mrmoje/RTR160_REMOTE_START/(list of files, cad)

Other CAD files:
firmware/PIC16f628A.X/dist/default/production/PIC16f628A.X.production.obj
firmware/PIC16f628A.X/l.obj
firmware/PIC16f628A.X/dist/default/production/p16f628a_test.X.production.obj
