mrmoje/RTR160_REMOTE_START/hardware/board.pdf

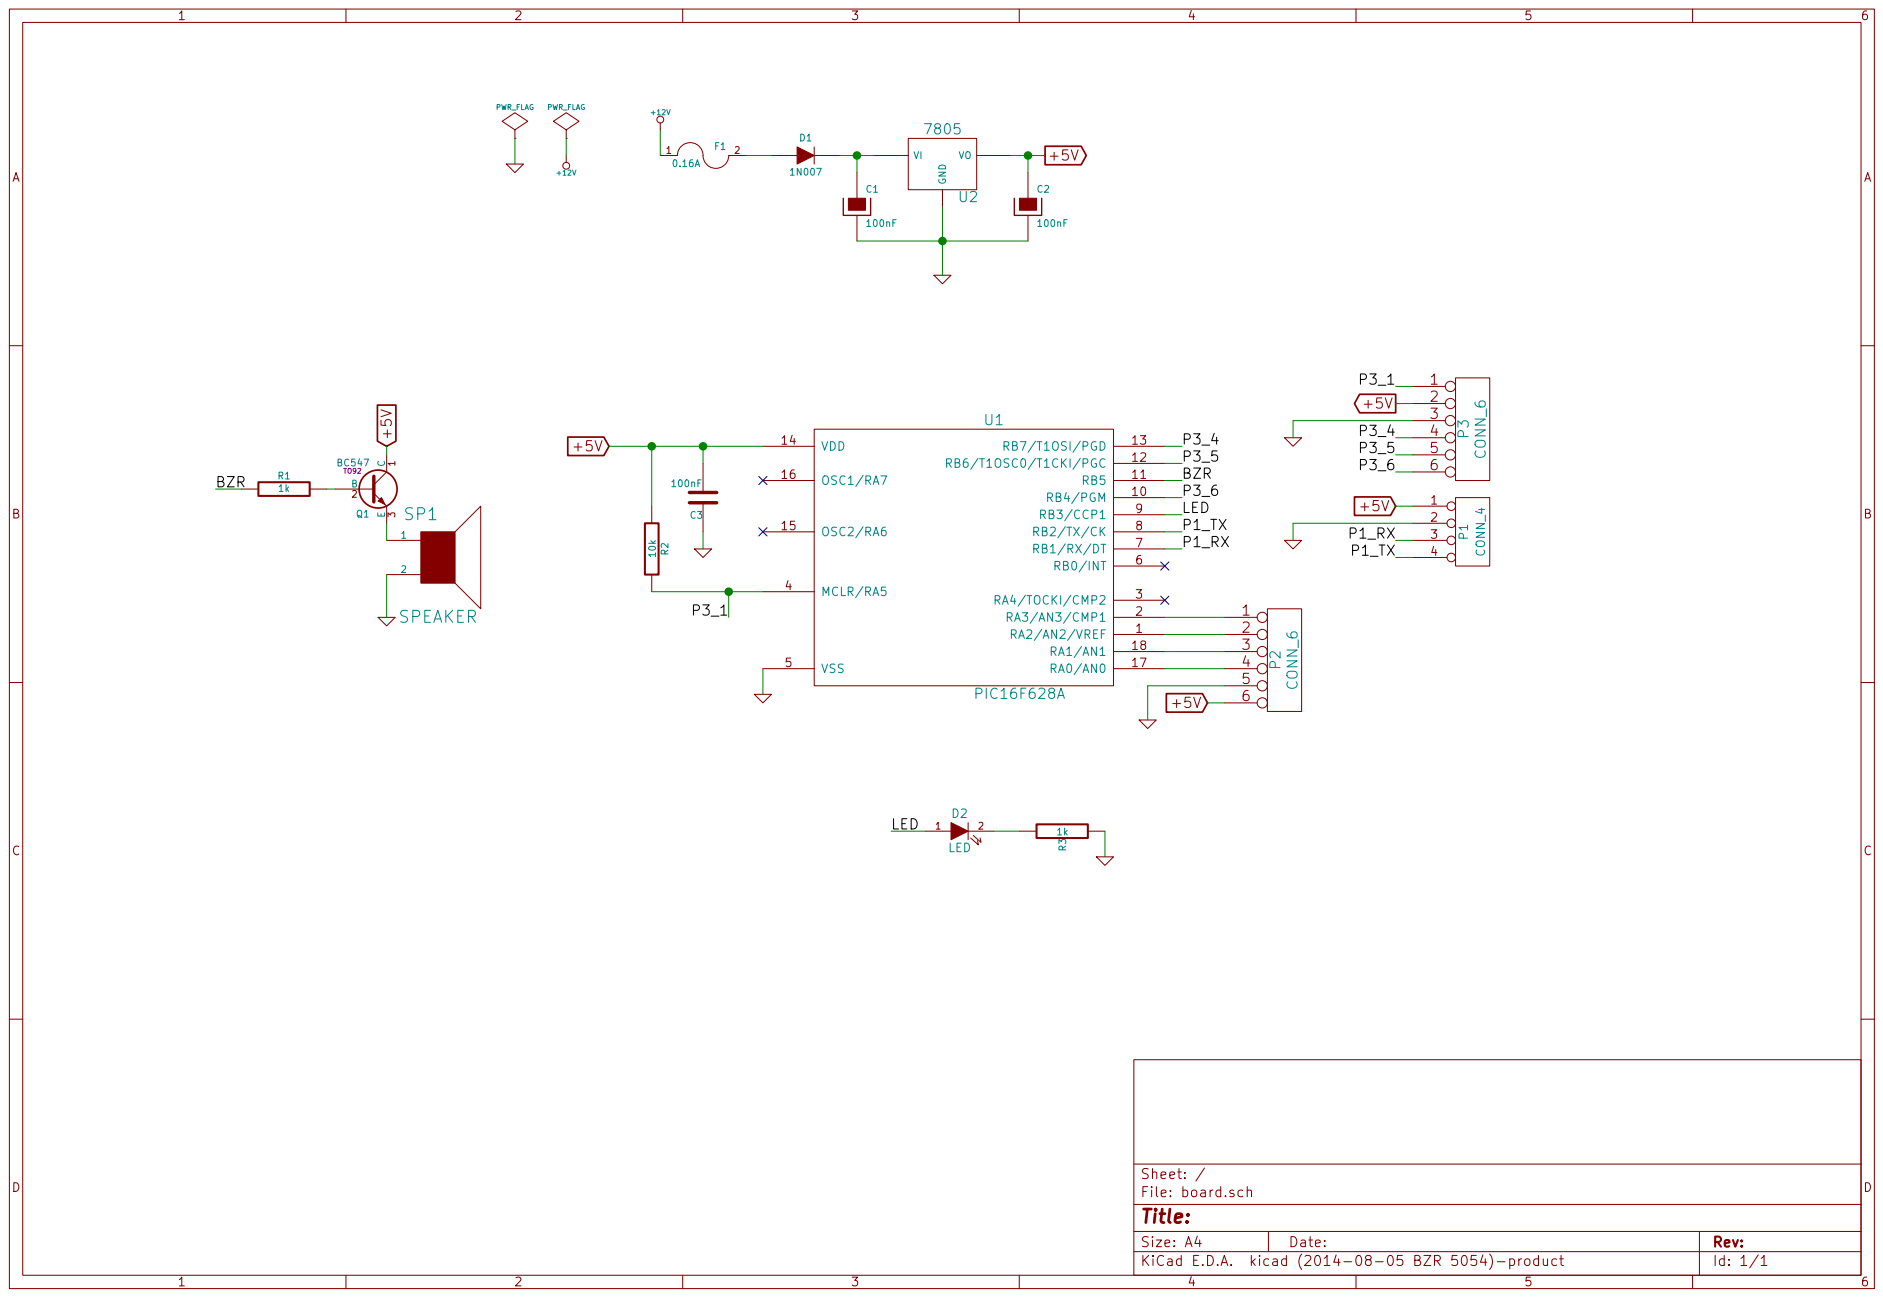
[picture p1: page 1]
