mrmoje/RTR160_REMOTE_START/(list of files, drawings)

Other design files:
hardware/frerouting_export/board.dsn
