mrmoje/RTR160_REMOTE_START/hardware/board.kicad_pcb

## KiCad design hardware/board.kicad_pcb (2014-12-31)

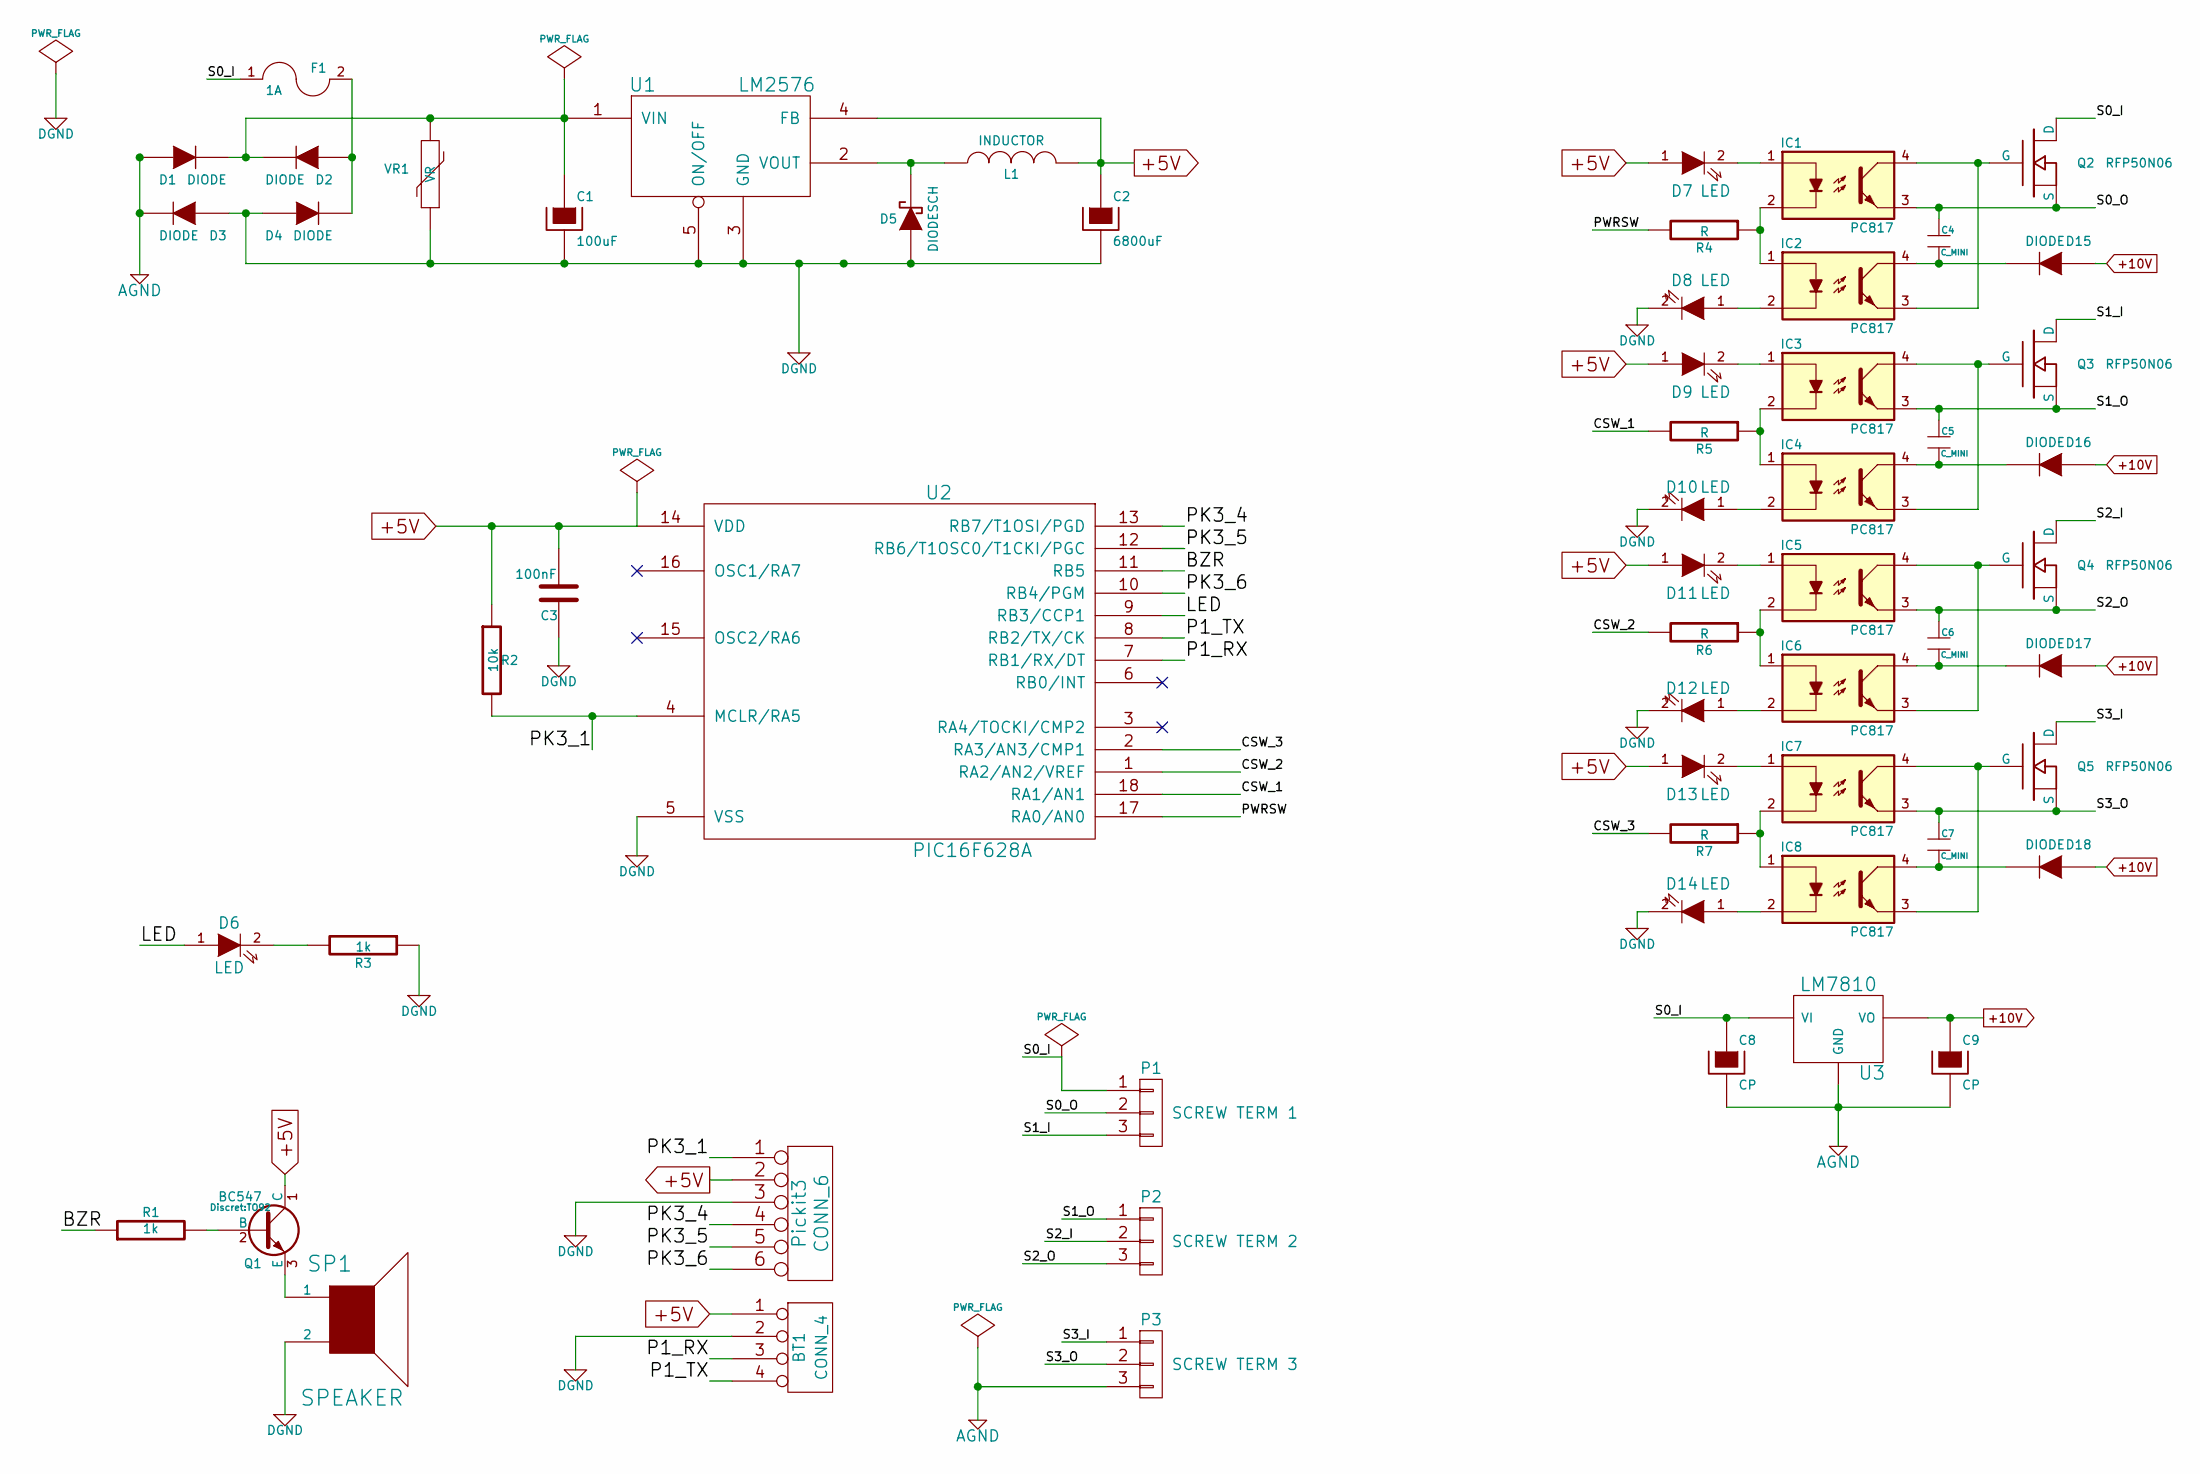
[picture p2: schematic board.sch]

Parts:
BT1: CONN_4; Pin_Header_Straight_1x04
C1: 100uF; Capacitor10x25RM2.5
C2: 6800uF; Capacitor16x25RM7.5
C3: 100nF; Capacitor7.5MMDiscRM5
C4, C5, C6, C7: C_MINI; Capacitor5x11RM2.5
C8, C9: CP; Capacitor8x13RM3.8
D1, D2, D3, D4, D15, D16, D17, D18: DIODE; Diode_DO-35_SOD27_Horizontal_RM10
D5: DIODESCH; Diode_DO-35_SOD27_Horizontal_RM10
D6, D7, D8, D9, D10, D11, D12, D13, D14: LED; LED-5MM
F1: 1A; Fuseholder5x20_horiz_SemiClosed_Casing10x25mm
IC1, IC2, IC3, IC4, IC5, IC6, IC7, IC8: PC817; DIP-4__300
L1: INDUCTOR; INDUCTOR_V
P1: SCREW TERM 1; bornier3
P2: SCREW TERM 2; bornier3
P3: SCREW TERM 3; bornier3
Pickit3: CONN_6; Pin_Header_Straight_1x06
Q1: BC547; TO92
Q2, Q3, Q4, Q5: RFP50N06; TO-220_FET-GDS_Vertical_LargePads
R1, R3: 1k; Resistor_Vertical_RM5mm
R2: 10k; Resistor_Vertical_RM5mm
R4, R5, R6, R7: R; Resistor_Horizontal_RM20mm
SP1: SPEAKER; MagneticBuzzer_ProSignal_ABI-009-RC
U1: LM2576; WAGO_734_5pin_Straight_RuggedPads
U2: PIC16F628A; DIP-18__300_ELL
U3: LM7810; 78XX
VR1: VR; Capacitor12MMDiscRM7.75

Connections:
+5V: BT1.1, C2.1, C3.2, D7.1 (A), D9.1 (A), D11.1 (A), D13.1 (A), L1.2, Pickit3.2, Q1.1 (C), R2.1, U1.4 (FB), U2.14 (VDD)
+10V: C9.1, D15.1 (A), D16.1 (A), D17.1 (A), D18.1 (A), U3.VO
/BZR: R1.1, U2.11 (RB5)
/CSW_1: R5.2, U2.18 (RA1/AN1)
/CSW_2: R6.2, U2.1 (RA2/AN2/VREF)
/CSW_3: R7.2, U2.2 (RA3/AN3/CMP1)
/LED: D6.1 (A), U2.9 (RB3/CCP1)
/P1_RX: BT1.3, U2.7 (RB1/RX/DT)
/P1_TX: BT1.4, U2.8 (RB2/TX/CK)
/PK3_1: Pickit3.1, R2.2, U2.4 (MCLR/RA5)
/PK3_4: Pickit3.4, U2.13 (RB7/T1OSI/PGD)
/PK3_5: Pickit3.5, U2.12 (RB6/T1OSC0/T1CKI/PGC)
/PK3_6: Pickit3.6, U2.10 (RB4/PGM)
/PWRSW: R4.2, U2.17 (RA0/AN0)
/S0_I: C8.1, F1.1, P1.1, Q2.D, U3.VI
/S0_O: C4.1 (A), IC1.3, P1.2, Q2.S
/S1_I: P1.3, Q3.D
/S1_O: C5.1 (A), IC3.3, P2.1, Q3.S
/S2_I: P2.2, Q4.D
/S2_O: C6.1 (A), IC5.3, P2.3, Q4.S
/S3_I: P3.1, Q5.D
/S3_O: C7.1 (A), IC7.3, P3.2, Q5.S
AGND: C8.2, C9.2, D1.1 (A), D3.2 (K), P3.3, U3.GND
DGND: BT1.2, C1.2, C2.2, C3.1, D3.1 (A), D4.1 (A), D5.1 (A), D8.2 (K), D10.2 (K), D12.2 (K), D14.2 (K), Pickit3.3, R3.1, SP1.2, U1.3 (GND), U1.5 (ON/OFF), U2.5 (VSS), VR1.1
unnamed: C1.1, D1.2 (K), D2.2 (K), U1.1 (VIN), VR1.2
unnamed: C4.2 (B), D15.2 (K), IC2.4
unnamed: C5.2 (B), D16.2 (K), IC4.4
unnamed: C6.2 (B), D17.2 (K), IC6.4
unnamed: C7.2 (B), D18.2 (K), IC8.4
unnamed: D2.1 (A), D4.2 (K), F1.2
unnamed: D5.2 (K), L1.1, U1.2 (VOUT)
unnamed: D6.2 (K), R3.2
unnamed: D7.2 (K), IC1.1
unnamed: D8.1 (A), IC2.2
unnamed: D9.2 (K), IC3.1
unnamed: D10.1 (A), IC4.2
unnamed: D11.2 (K), IC5.1
unnamed: D12.1 (A), IC6.2
unnamed: D13.2 (K), IC7.1
unnamed: D14.1 (A), IC8.2
unnamed: IC1.2, IC2.1, R4.1
unnamed: IC1.4, IC2.3, Q2.G
unnamed: IC3.2, IC4.1, R5.1
unnamed: IC3.4, IC4.3, Q3.G
unnamed: IC5.2, IC6.1, R6.1
unnamed: IC5.4, IC6.3, Q4.G
unnamed: IC7.2, IC8.1, R7.1
unnamed: IC7.4, IC8.3, Q5.G
unnamed: Q1.2 (B), R1.2
unnamed: Q1.3 (E), SP1.1

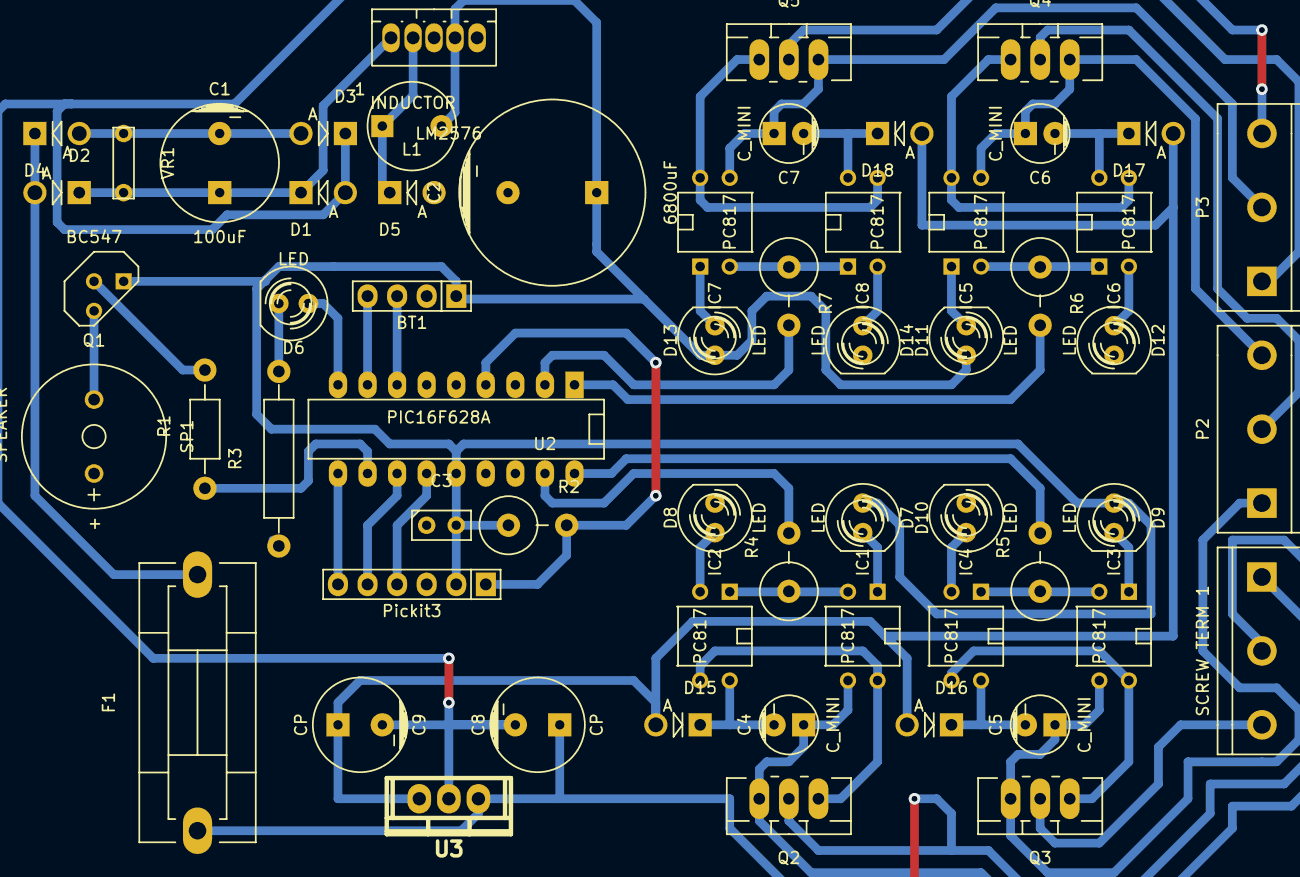
[picture p3: board board.kicad_pcb from above]

Board: 2 copper layers, 59 parts (0 on the bottom side), 50 nets.
