mrmoje/RTR160_REMOTE_START/(commit log)

2014-10-18 Initial prototype. Works better on external power
    Suffers from brownouts and other power-related
    gotchas when powered from the bike.
    [PIC16f628A.X.production.obj, board.dsn, board.kicad_pcb, board.sch, l.obj, p16f628a_test.X.production.obj]
2014-10-18 Replace LM7805 LVR with LM2576 Buck Converter
    Switched to a more efficient power supply plus add a large-ass capacitor
    to postpone brownouts during ignition.
    closes #1
    closes #3
    [board.sch]
2014-11-04 Refactor schema to include MOSFET & optocouplers
    Use N-channel MOSFETS for "high-side" switching
    Add optocouplers to isolate control & bike circuits
    10V LVR for bootstrap cap charge/power supply
    Purge mislabeled connector (P2 was mislabeled as Pickit 3 conn)
    Add screw terminal connectors
    (labeling/numbering is still incomplete)
    [board.sch]
2014-11-05 JZ: Label everything + ugly power tag workaround
    [board.kicad_pcb, board.sch]
2014-12-29 Heavily modded pcb + New footprint associations
    [board.kicad_pcb, board.sch]
2014-12-31 Forgot to connect power trace to uC & bt modules
    Discovered after second etch [facepalm]
    [board.kicad_pcb]
